hardware-samelement/energy-monitor/PCB/Energy_Monitor/Project Outputs for Energy_Monitor/3d view.png

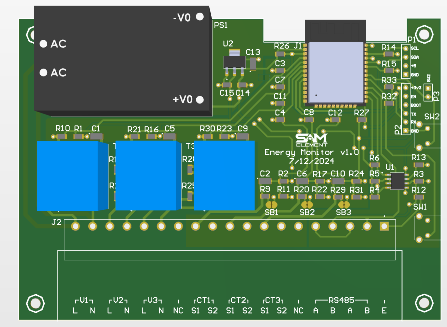
PCB/Energy_Monitor/Project Outputs for Energy_Monitor/3d view.png
