hardware-samelement/energy-monitor/PCB/Energy_Monitor/Project Outputs for Energy_Monitor/BOM_Energy_Monitor.xlsx

Sheet: BOM Report
Bill of Materials |  |  | Bill of Materials for Project [Energy_Monitor.PrjPcb] (No PCB Document Selected)
Source Data From: |  | Energy_Monitor.PrjPcb
Project: |  | Energy_Monitor.PrjPcb
Variant: |  | None
Creation Date: | 7/19/2024 | 11:07
Print Date: | 2024-09-17 | 14:05:40
Footprint | Comment | LibRef | Designator | Link 1 | Link 2 | Quantity
C1206 | C Tantalum 10u | Cap Pol1 | C1, C2, C5, C6, C9, C10, C13 | https://www.tokopedia.com/jogjarobotika/smd-tantalum-1206-10uf-16v-10?extParam=src%3Dshop%26whid%3D3000837 | https://www.tokopedia.com/lisuinstrument/10uf-10-16v-3216-mm-1206-inch-smd-tantalum-capacitor-ca45-a016k106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 | 7
6-0805_N | C 100n | Cap | C3, C4, C7, C8, C11, C12, C14, C15 | https://www.tokopedia.com/jogjarobotika/100nf-smd0805-capacitor?extParam=src%3Dshop%26whid%3D3000837 | https://www.tokopedia.com/lisuinstrument/100nf-10-50v-x7r-0805-2012-mm-smd-capacitor-cc0805krx7r9bb104-yageo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 | 8
LEDC2012X70N | LED 0805 | 597-3305-607F | D1, D3, D5, D7, D8, D9 | https://www.tokopedia.com/jogjarobotika/led-smd-0805-merah?extParam=src%3Dshop%26whid%3D3000837 | https://www.tokopedia.com/lisuinstrument/0805-smd-led-smt-ultra-bright-berbagai-pilihan-warna-merah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 | 6
DIOM5227X270N | 1N4007 | S1M | D2, D4, D6 | https://www.tokopedia.com/jogjarobotika/1n4007-smd-m7-1a-smd | https://www.tokopedia.com/lisuinstrument/1n4007-in4007-4007-m7-do-214ac-sma-smd-smt-diode-yongyutai-43f81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 | 3
ESP32-WROOM-32E | ESP32-WROOM-32E | ESP32-WROOM-32E | J1 |  |  | 1
CUI_TBP01R1-508-19BE | Terminal Block Right angle 19Pin | TBP01R1-508-19BE | J2 | (5x 3pin, 1x4pin) |  | 1
HDR1X4 | Header 4 | Header 4 | P1 |  |  | 1
HDR1X6 | Header 6 | Header 6 | P2 |  |  | 1
HDR1X2 | Header 2 | Header 2 | P3 |  |  | 1
CONV_HLK-10M05 | HLK-10M05 | HLK-10M05 | PS1 | https://www.tokopedia.com/iotstore/hi-link-hlk-10m05-ac-to-dc-isolated-5v-2a-10-watt |  | 1
6-0805_N | R 200K | Res1 | R1, R2, R7, R10, R11, R16, R17, R18, R21, R22, R23, R24, R25, R30, R31, R35, R36, R37 |  | https://www.tokopedia.com/lisuinstrument/smd-200k-ohm-resistor-0805-1-smt?extParam=src%3Dshop%26whid%3D580205 | 18
6-0805_N | R 10K | Res1 | R3, R4, R5, R6, R13, R26, R27, R32, R33 | https://www.tokopedia.com/jogjarobotika/10k-ohm-smd0805-resistor-1?extParam=src%3Dshop%26whid%3D3000837 | https://www.tokopedia.com/lisuinstrument/10k-0805-0-1-thin-film-resistor-smd-10k-10ppm-c-125mw-1002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 | 9
6-0805_N | R 500 / 470 | Res1 | R8, R19, R28, R38, R39, R40 | https://www.tokopedia.com/jogjarobotika/470-ohm-smd0805-resistor?extParam=src%3Dshop%26whid%3D3000837 | https://www.tokopedia.com/lisuinstrument/470-0805-0-5-125mw-150v-25ppm-high-precision-thin-resistor-470r-4700-arg05dtc4700-viking-tech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 | 6
6-0805_N | R 22 | Res1 | R9, R20, R29 | https://www.tokopedia.com/jogjarobotika/22-ohm-smd0805-resistor-1?extParam=src%3Dshop%26whid%3D3000837 | https://www.tokopedia.com/lisuinstrument/smd-22r-resistor-0805-1-smt-22-22-ohm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 | 3
6-0805_N | R 120 | Res1 | R12 | https://www.tokopedia.com/jogjarobotika/120-ohm-smd0805-resistor-1?extParam=src%3Dshop%26whid%3D3000837 | https://www.tokopedia.com/lisuinstrument/120r-0805-1-thick-film-resistors-smd-chip-resistor-1200-121-120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 | 1
6-0805_N | R 4K7 | Res1 | R14, R15 | https://www.tokopedia.com/jogjarobotika/4k7-ohm-smd0805-resistor | https://www.tokopedia.com/lisuinstrument/4-7k-0805-1-125mw-150v-100ppm-thick-resistor-4-7k-4k7-4701-rs-05k4701ft-fenghua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 | 2
6-0805_N | R 0 | Res1 | R34 |  |  | 1
Solder Bridge | solder Bridge | solder Bridge | SB1, SB2, SB3 |  |  | 3
SW_1825027-5 | Tactile Switch Right Angle | 1825027-5 | SW1, SW2 |  |  | 2
XFMR_ZMPT101B | ZMPT101B | ZMPT101B | T1, T2, T3 | https://www.tokopedia.com/aisyahrobot/potentioal-transformer-pt101b-zmpt101b-trafo-mini |  | 3
SOIC127P600X175-8N | MAX485ESA+T | MAX485ESA+T | U1 |  |  | 1
SOT229P700X180-4N | AMS1117-3.3 | AMS1117-3.3 | U2 |  |  | 1
 | BOX |  |  | https://www.tokopedia.com/jogjarobotika/plastic-industrial-box-plc-2-02c-145x90x41mm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
 |  |  |  |  |  | 80
Approved |  | Notes

Sheet: Project Information
Project Full Path | C:\Users\hanif\Documents\Tes\Energy_Monitor\Energy_Monitor.PrjPcb
Project Filename | Energy_Monitor.PrjPcb
Variant Name | None
Data-Source Filename | Energy_Monitor.PrjPcb
Data-Source Full Path | C:\Users\hanif\Documents\Tes\Energy_Monitor\Energy_Monitor.PrjPcb
Title | Bill of Materials for Project [Energy_Monitor.PrjPcb] (No PCB Document Selected)
Total Quantity | 80
Report Time | 11:07
Report Date | 7/19/2024
Report Date & Tine | 7/19/2024 11:07
Output Name | Bill of Materials
Output Type | BOM_PartType
Output Generator Name | BOM
Output Generator Description | Bill of Materials
