hardware-samelement/energy-monitor/PCB/Energy_Monitor/Project Outputs for Energy_Monitor/BOM_Energy_Monitor_1.xlsx

Sheet: BOM Report
Bill of Materials |  |  | Bill of Materials for Project [Energy_Monitor.PrjPcb] (No PCB Document Selected)
Source Data From: |  | Energy_Monitor.PrjPcb
Project: |  | Energy_Monitor.PrjPcb
Variant: |  | None
Creation Date: | 9/17/2024 | 13:21
Print Date: | 2024-09-17 | 13:21:51
Footprint | Comment | LibRef | Designator | Description | Quantity
C1206 | C Tantalum 10u | Cap Pol1 | C1, C2, C5, C6, C9, C10, C13 | Polarized Capacitor (Radial) | 7
6-0805_N | C 100n | Cap | C3, C4, C7, C8, C11, C12, C14, C15 | Capacitor | 8
LEDC2012X70N | LED 0805 | 597-3305-607F | D1, D3, D5, D7, D8, D9 | LED Uni-Color Green 4-Pin Chip 0805 T/R | 6
DIOM5227X270N | 1N4007 | S1M | D2, D4, D6 | Diode Standard 1000 V 1A Surface Mount DO-214AC (SMA) | 3
ESP32-WROOM-32E | ESP32-WROOM-32E | ESP32-WROOM-32E | J1 | ESP32-WROOM-32E | 1
CUI_TBP01R1-508-19BE | Terminal Block Right angle 19Pin | TBP01R1-508-19BE | J2 |  | 1
JST_B4B-XH-A(LF)(SN) | Header 4 | Header 4 | P1 | Header, 4-Pin | 1
HDR1X6 | Header 6 | Header 6 | P2 | Header, 6-Pin | 1
HDR1X2 | Header 2 | Header 2 | P3 | Header, 2-Pin | 1
CONV_HLK-10M05 | HLK-10M05 | HLK-10M05 | PS1 | 10W Ultra-Compact Power Module | 1
SOT95P240X111-3N | BSS138 | BSS138 | Q1, Q2 | N-Channel 50V 220mA (Ta) 360mW (Ta) Surface Mount SOT-23-3 | 2
6-0805_N | R 200K | Res1 | R1, R2, R7, R10, R11, R16, R17, R18, R21, R22, R23, R24, R25, R30, R31, R35, R36, R37 | Resistor | 18
6-0805_N | R 10K | Res1 | R3, R4, R5, R6, R13, R14, R15, R26, R27, R32, R33, R41, R42 | Resistor | 13
6-0805_N | R 500 | Res1 | R8, R19, R28, R38, R39, R40 | Resistor | 6
6-0805_N | R 22 | Res1 | R9, R20, R29 | Resistor | 3
6-0805_N | R 120 | Res1 | R12 | Resistor | 1
6-0805_N | R 0 | Res1 | R34 | Resistor | 1
Solder Bridge | solder Bridge | solder Bridge | SB1, SB2, SB3 |  | 3
SW_1825027-5 | Tactile Switch Right Angle | 1825027-5 | SW1 | Switch Tactile OFF (ON) SPST Round Button PC Pins 0.05A 24VDC 1.57N Thru-Hole Loose Piece | 1
XFMR_ZMPT101B | ZMPT101B | ZMPT101B | T1, T2, T3 | Current-type Voltage Transformer | 3
SOIC127P600X175-8N | MAX485ESA+T | MAX485ESA+T | U1 | 1/1 Transceiver Half RS422, RS485 8-SOIC | 1
SOT229P700X180-4N | AMS1117-3.3 | AMS1117-3.3 | U2 | Sot223/Pkg 1-Amp 3.3-Volt Low Drop Out Voltage Regulatator | 1
 |  |  |  |  | 83
Approved |  | Notes

Sheet: Project Information
Project Full Path | D:\Projek\Energy Monitor Project\PCB\Energy_Monitor\Energy_Monitor.PrjPcb
Project Filename | Energy_Monitor.PrjPcb
Variant Name | None
Data-Source Filename | Energy_Monitor.PrjPcb
Data-Source Full Path | D:\Projek\Energy Monitor Project\PCB\Energy_Monitor\Energy_Monitor.PrjPcb
Title | Bill of Materials for Project [Energy_Monitor.PrjPcb] (No PCB Document Selected)
Total Quantity | 83
Report Time | 13:21
Report Date | 9/17/2024
Report Date & Tine | 9/17/2024 13:21
Output Name | Bill of Materials
Output Type | BOM_PartType
Output Generator Name | BOM
Output Generator Description | Bill of Materials
