hardware-samelement/energy-monitor/PCB/Energy_Monitor/Project Outputs for Energy_Monitor/Energy_Monitor1.xls

Sheet: BOM Report
Bill of Materials |  |  | Bill of Materials for Project [Energy_Monitor.PrjPcb] (No PCB Document Selected)
Source Data From: |  | Energy_Monitor.PrjPcb
Project: |  | Energy_Monitor.PrjPcb
Variant: |  | None
Creation Date: | 7/12/2024 | 15:26
Print Date: | 2024-07-12 | 15:26:34
Footprint | Comment | LibRef | Designator | Description | Quantity
C1206 | C Tantalum 10u | Cap Pol1 | C1, C2, C5, C6, C9, C10, C13 | Polarized Capacitor (Radial) | 7
6-0805_N | C 100n | Cap | C3, C4, C7, C8, C11, C12, C14, C15 | Capacitor | 8
ESP32-WROOM-32E | ESP32-WROOM-32E | ESP32-WROOM-32E | J1 | ESP32-WROOM-32E | 1
CUI_TBP01R1-508-19BE | Terminal Block Right angle 19Pin | TBP01R1-508-19BE | J2 |  | 1
HDR1X4 | Header 4 | Header 4 | P1 | Header, 4-Pin | 1
HDR1X6 | Header 6 | Header 6 | P2 | Header, 6-Pin | 1
HDR1X2 | Header 2 | Header 2 | P3 | Header, 2-Pin | 1
CONV_HLK-10M05 | HLK-10M05 | HLK-10M05 | PS1 | 10W Ultra-Compact Power Module | 1
6-0805_N | R 200K | Res1 | R1, R2, R7, R10, R11, R16, R17, R18, R21, R22, R23, R24, R25, R30, R31 | Resistor | 15
6-0805_N | R 10K | Res1 | R3, R4, R5, R6, R13, R26, R27, R32, R33 | Resistor | 9
6-0805_N | R 500 | Res1 | R8, R19, R28 | Resistor | 3
6-0805_N | R 22 | Res1 | R9, R20, R29 | Resistor | 3
6-0805_N | R 120 | Res1 | R12 | Resistor | 1
6-0805_N | R 4K7 | Res1 | R14, R15 | Resistor | 2
6-0805_N | R 0 | Res1 | R34 | Resistor | 1
Solder Bridge | solder Bridge | solder Bridge | SB1, SB2, SB3 |  | 3
SW_1825027-5 | Tactile Switch Right Angle | 1825027-5 | SW1, SW2 | Switch Tactile OFF (ON) SPST Round Button PC Pins 0.05A 24VDC 1.57N Thru-Hole Loose Piece | 2
XFMR_ZMPT101B | ZMPT101B | ZMPT101B | T1, T2, T3 | Current-type Voltage Transformer | 3
SOIC127P600X175-8N | MAX485ESA+T | MAX485ESA+T | U1 | 1/1 Transceiver Half RS422, RS485 8-SOIC | 1
SOT229P700X180-4N | AMS1117-3.3 | AMS1117-3.3 | U2 | Sot223/Pkg 1-Amp 3.3-Volt Low Drop Out Voltage Regulatator | 1
 |  |  |  |  | 65
Approved |  | Notes

Sheet: Project Information
Project Full Path | C:\Users\hanif\Documents\Tes\Energy_Monitor\Energy_Monitor.PrjPcb
Project Filename | Energy_Monitor.PrjPcb
Variant Name | None
Data-Source Filename | Energy_Monitor.PrjPcb
Data-Source Full Path | C:\Users\hanif\Documents\Tes\Energy_Monitor\Energy_Monitor.PrjPcb
Title | Bill of Materials for Project [Energy_Monitor.PrjPcb] (No PCB Document Selected)
Total Quantity | 65
Report Time | 15:26
Report Date | 7/12/2024
Report Date & Tine | 7/12/2024 15:26
Output Name | Bill of Materials
Output Type | BOM_PartType
Output Generator Name | BOM
Output Generator Description | Bill of Materials
