hardware-samelement/energy-monitor/PCB/Energy_Monitor/Project Outputs for Energy_Monitor/pcb_energy_monitor.pdf

# +3V3 SCL

# +3V3 SDA

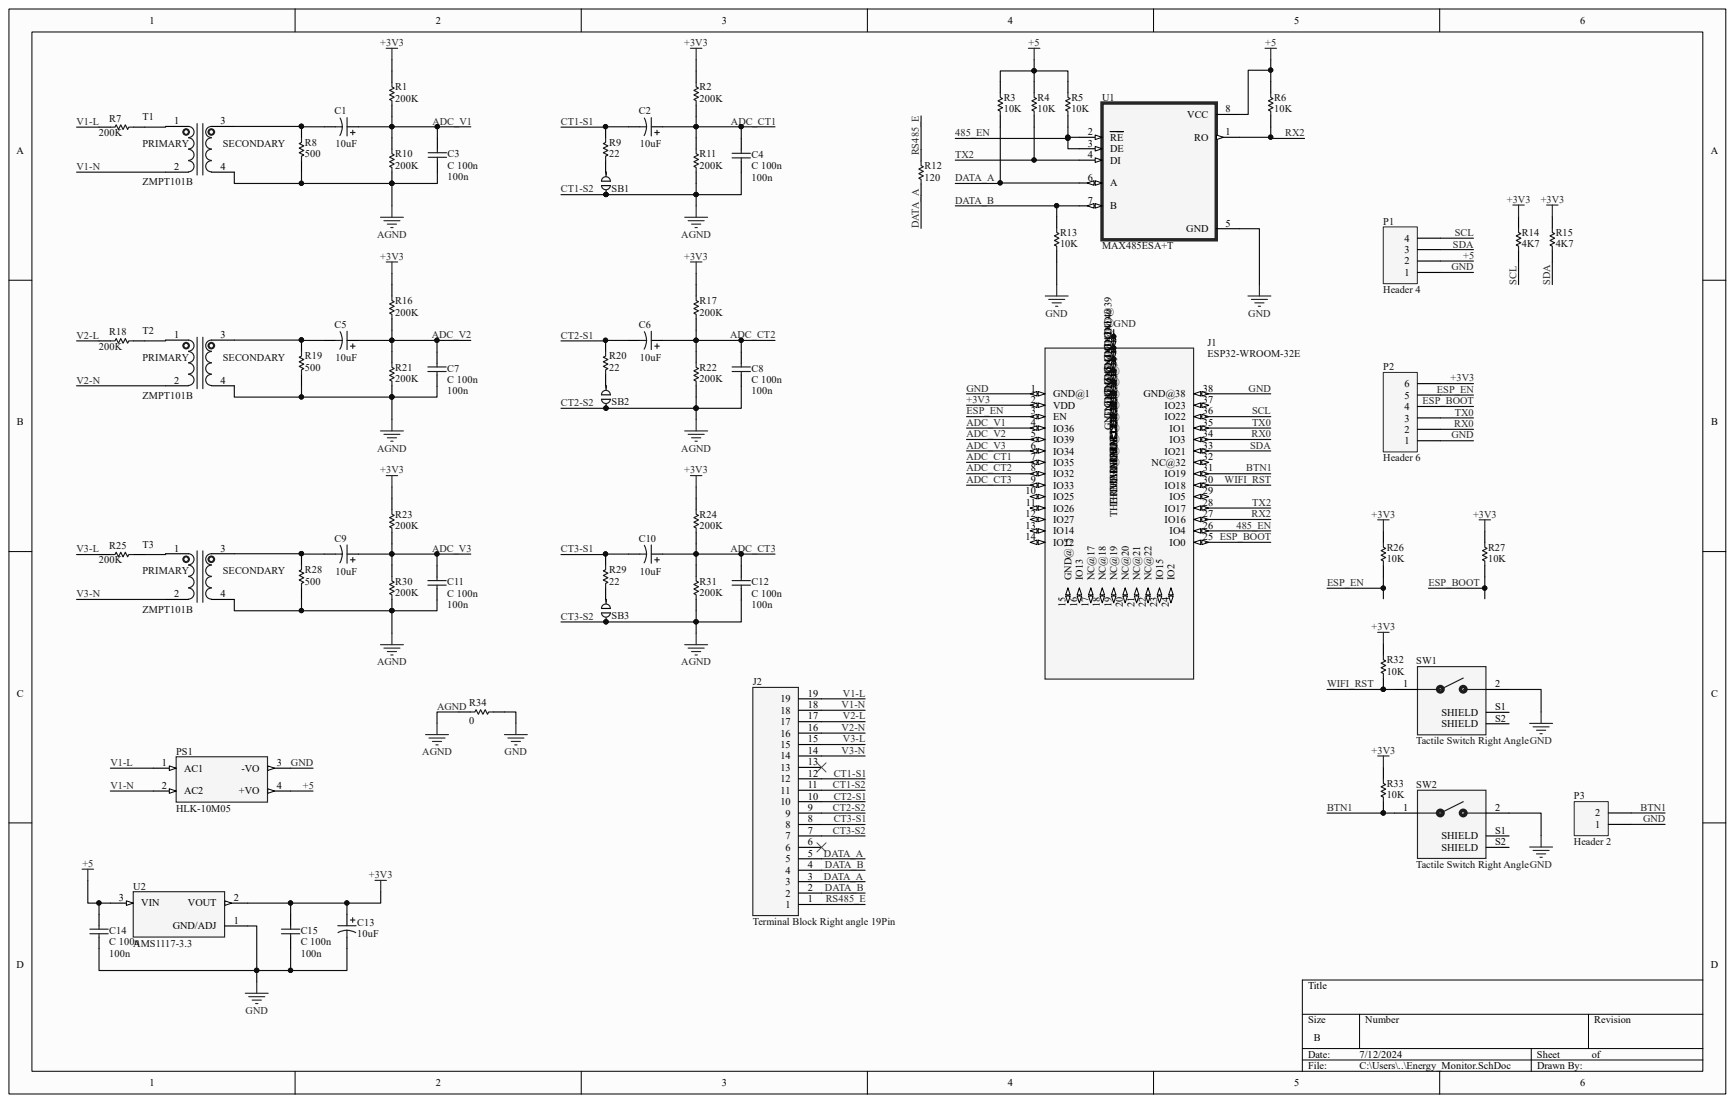
[picture p58: page 1]

Tactile Switch Right Angle

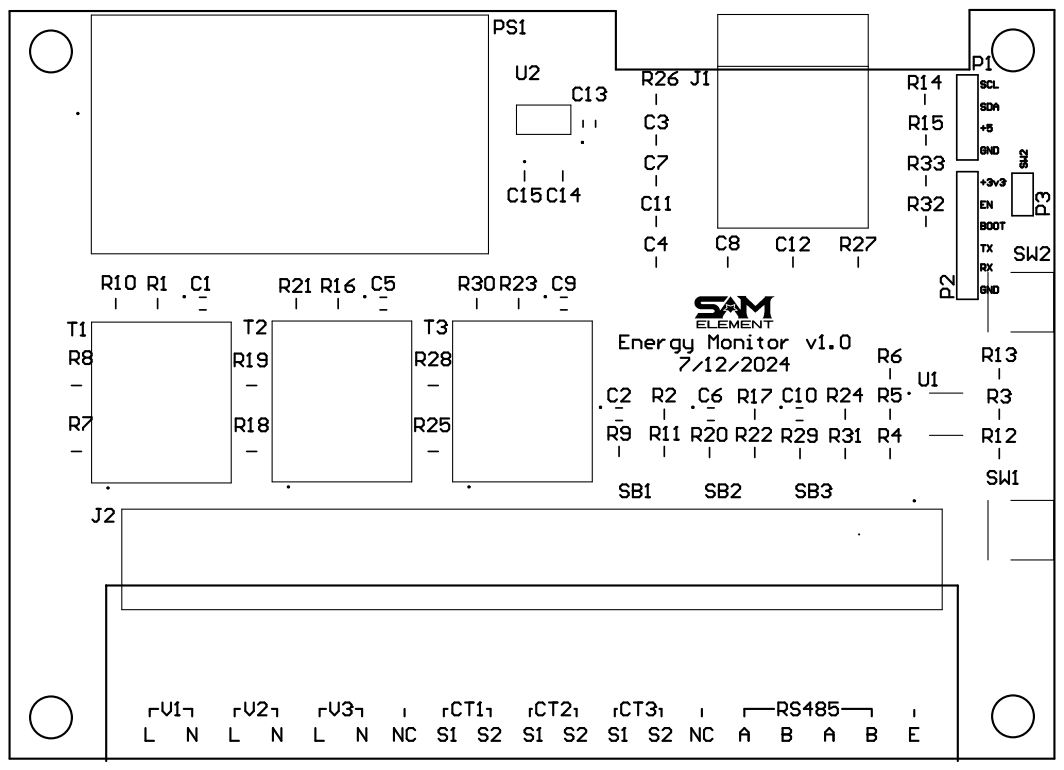
[picture p59: page 2]

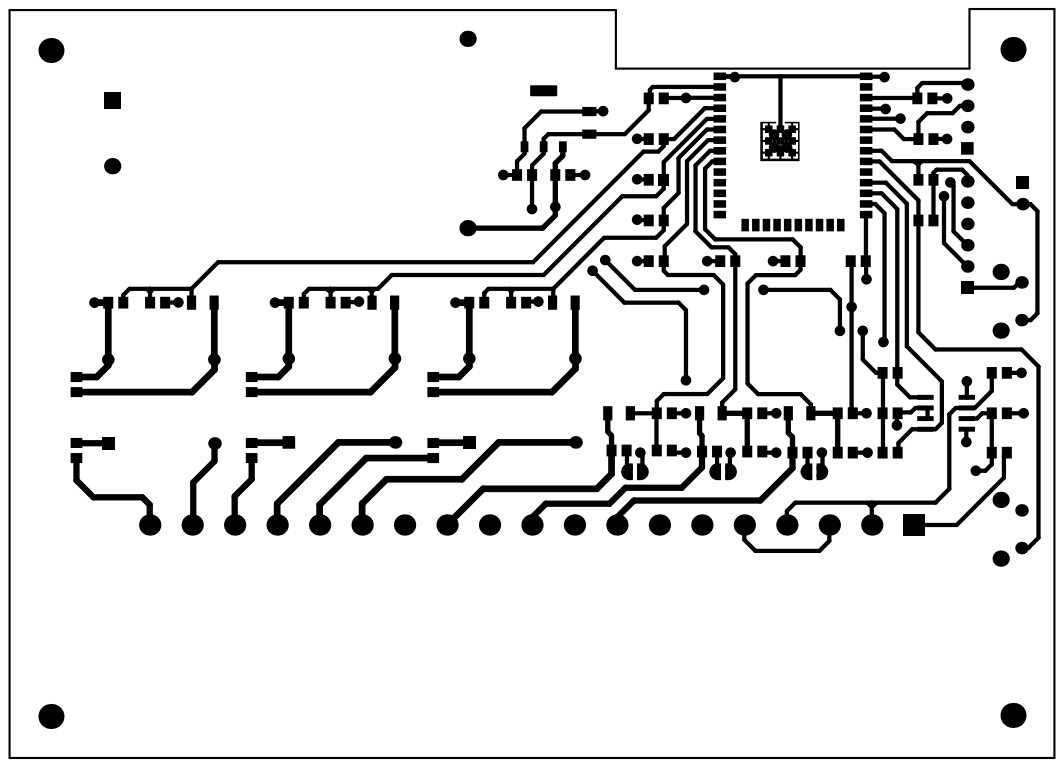
[picture p60: page 3]

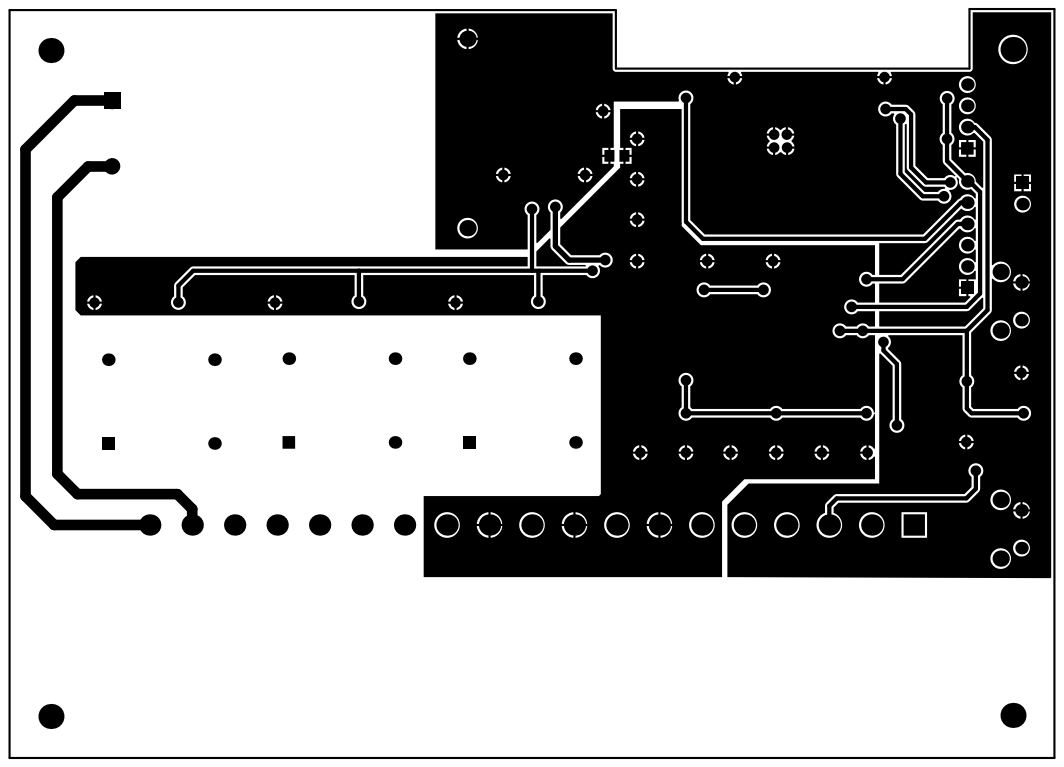
[picture p61: page 4]

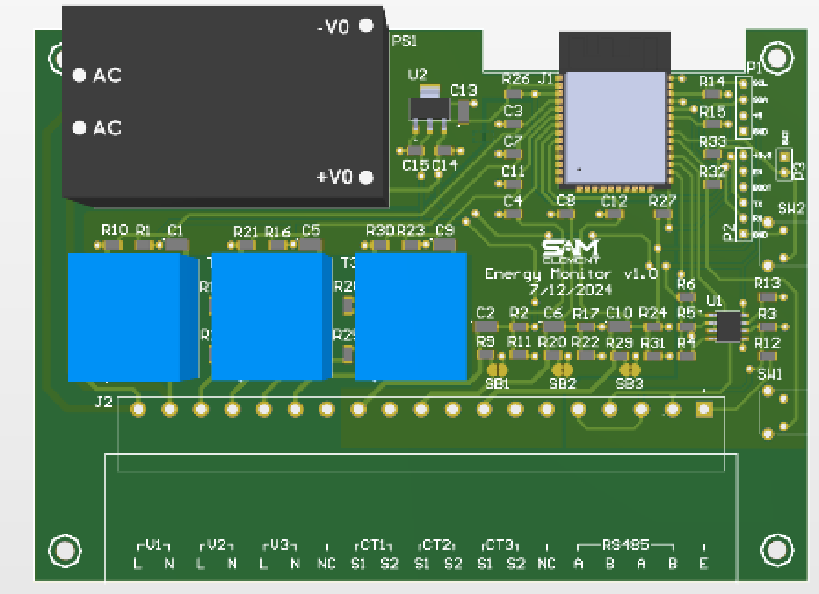
[picture p62: page 5]
