hardware-samelement/energy-monitor/PCB/Energy_Monitor/Project Outputs for Energy_Monitor/skema.pdf

# +3V3 SCL

# +3V3 SDA


Tactile Switch Right Angle
