hardware-samelement/energy-monitor/(list of files, drawings)

Other design files:
PCB/Energy_Monitor/Energy_Monitor.PcbDoc
PCB/Energy_Monitor/Energy_Monitor.PrjPcb
PCB/Energy_Monitor/Energy_Monitor.SchDoc
