hardware-samelement/energy-monitor/(commit log)

2024-11-29 add calibration via mqtt
    add calibration setting for voltage and current via mqtt.
2025-02-27 change local repo directory
    add document and pcb file to the repo
    [BOM_Energy_Monitor(1).xlsx, BOM_Energy_Monitor.xlsx, BOM_Energy_Monitor_1.xlsx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]
